soyFACE/chamberozonecontrol/Documentation/wiring diagram/wiring diagram.kicad_pcb

## KiCad design connectors.kicad_sch

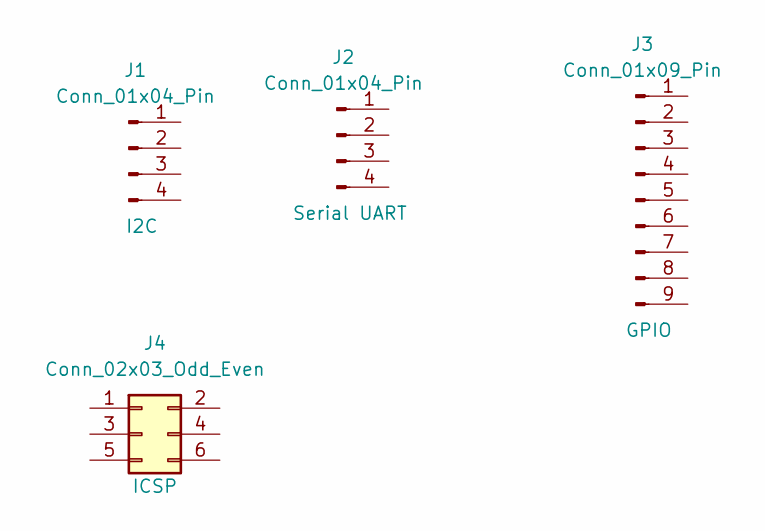
[picture p1: schematic connectors.kicad_sch]

Parts:
J1, J2: Conn_01x04_Pin
J3: Conn_01x09_Pin
J4: Conn_02x03_Odd_Even
