soyFACE/chamberozonecontrol/(commit log)

2024-11-18 Initial Arduino files
    Initial Arduino files for Arduino-controlled ozone controller using UV.
    ozonepidcontrol_2024-09-03.ino is a currently working version that will be improved after hardware changes.
    10v_dac_testing,ino is a testing file to use DFR0971 serial controlled DAC.
2025-03-31 Moved files to same named folder so they will work with Arduino IDE and made new undated program
2025-03-31 Added Python script that reads the serial port and records data
    Run this script on a PC connected to the Arduino to record the data to a file based on the date the file was run, and set the start and end times.
2026-09-10 Create wiring table.xlsx
    [wiring table.xlsx]
2026-09-10 wire diagrams and updated wire table
    [wiring diagram.kicad_pcb, wiring diagram.kicad_sch]
2026-09-10 Update wiring table.xlsx
    [wiring table.xlsx]
2026-09-11 updated changes to wiring diagram
    [wiring diagram.kicad_sch, wiring table.xlsx]
2026-09-11 added wiring diagram PDF
2026-09-11 Changed desc in wiring diagram
    [wiring diagram.kicad_sch]
2026-09-11 Rename wiring diagram.pdf to wiring diagram R1.pdf
2026-09-13 Added new Arduino file with door sensor code.
